Nour3000/capteur-intelligent-3-voies/docs/images/diagnostic.png

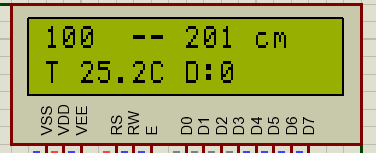
docs/images/diagnostic.png
