Nour3000/capteur-intelligent-3-voies/docs/images/terminal.png

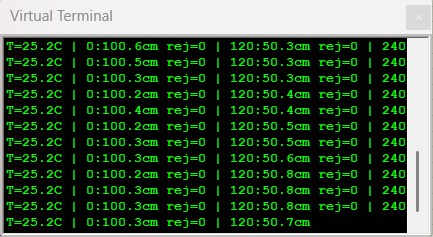
docs/images/terminal.png
