Nour3000/capteur-intelligent-3-voies/simulation/matlab/figures/bilan_energetique.png

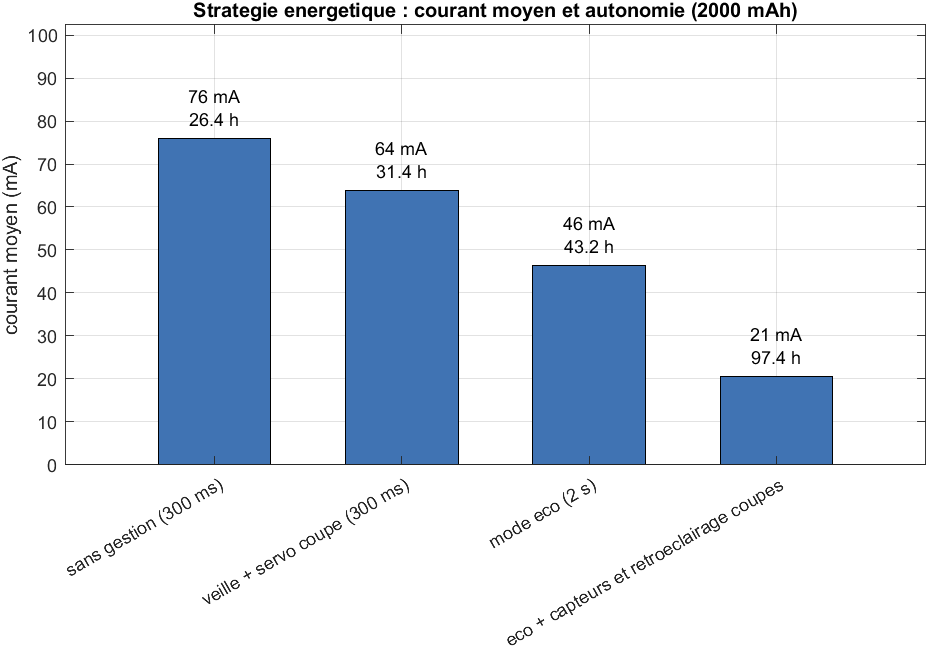
simulation/matlab/figures/bilan_energetique.png
