Nour3000/capteur-intelligent-3-voies/simulation/matlab/figures/cr_fig2.png

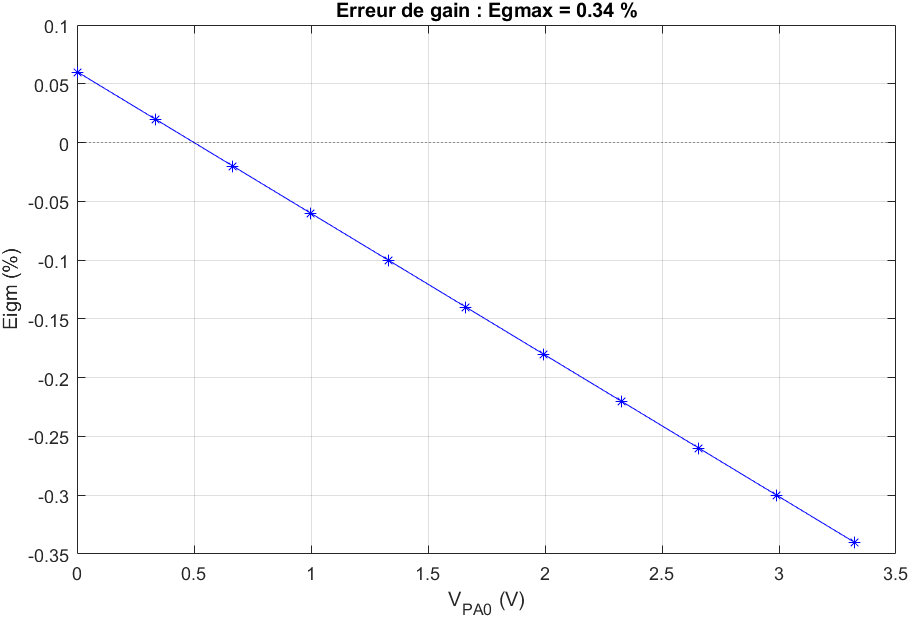
simulation/matlab/figures/cr_fig2.png
