Nour3000/capteur-intelligent-3-voies/(list of files, drawings)

Other design files:
hardware/capteur_PCB.pdsprj
simulation/proteus/capteur_simulation.pdsprj
