Nour3000/capteur-intelligent-3-voies/(commit log)

2026-10-12 Capteur de distance 3 voies : simulation, firmware et PCB
    Simulation Proteus et étude MATLAB de la chaîne de mesure, firmware
    pour la BluePill, PCB de 100 x 80 mm avec Gerber et nomenclature.
    [BOM.csv, capteur_PCB.pdsprj, capteur_simulation.pdsprj]
2026-11-01 Capteur intelligent : diagnostic, auto-calibration, mode éco, rapport et nouveau README
    [capteur_simulation.pdsprj]
